dainezasc/Environmental-Weather-Station-Unit-system/20181211_170753.jpg

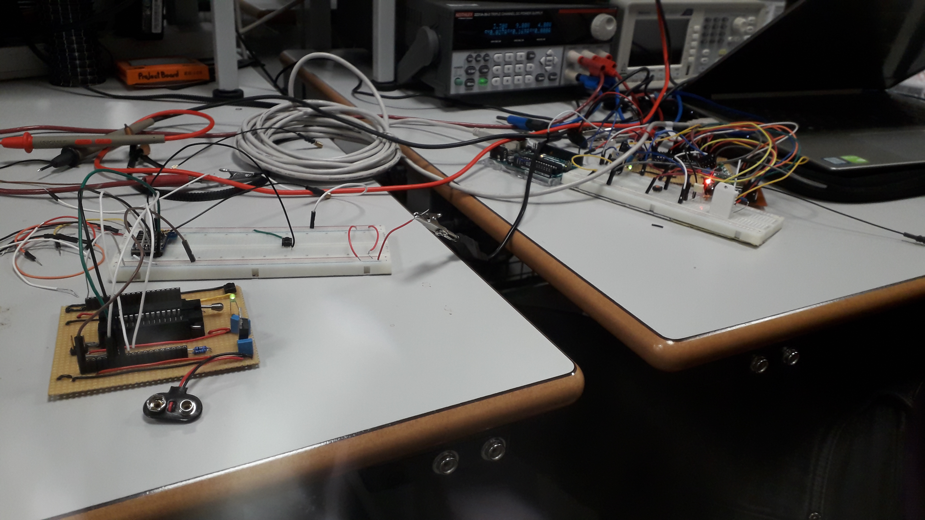
20181211_170753.jpg
