dainezasc/Environmental-Weather-Station-Unit-system/20181211_170759.jpg

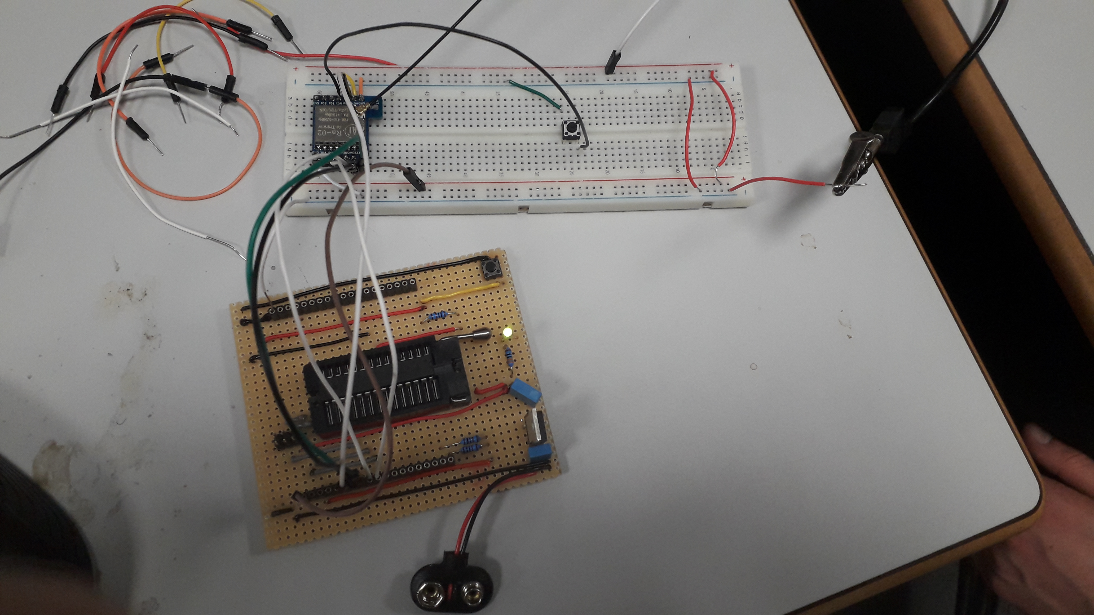
20181211_170759.jpg
