dainezasc/Environmental-Weather-Station-Unit-system/README.md

# Environmental-Weather-Station-Unit-system
A system of sensors using LoRa communication to send measurements to a receiver. Done as 3rd semester project for UCL IT Technology - Electronics.
