dainezasc/Environmental-Weather-Station-Unit-system/(list of files, drawings)

Other design files:
schematics/SENSOR BOARD.DSN
schematics/Sensor board.opj
