dainezasc/Environmental-Weather-Station-Unit-system/(notices)

Notices in the files:
LoraSensorTest/LoraSensorTest/DHT22int.c:
DHT22 Interrupt Driven library for AVR is free software: you can redistribute
it and/or modify it under the terms of the GNU General Public License
